trabaSanchez/Entrega-final.-Proyecto-IoT/Proyecto KiCAD(Esquematico-PCB)/simbolos descargados/CD4050BD/CD4050BD.step

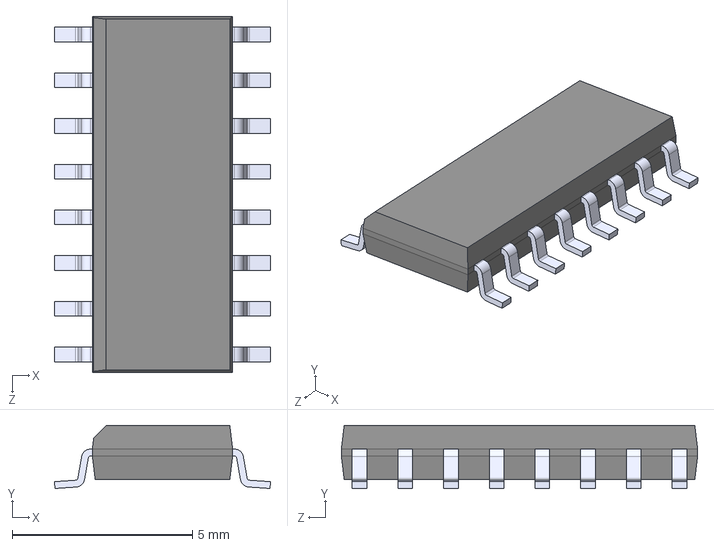
[picture p27: CAD file, 2020-12-07]
Proyecto KiCAD(Esquematico-PCB)/simbolos descargados/CD4050BD/CD4050BD.step
6.00 x 1.75 x 9.90 mm
