trabaSanchez/Entrega-final.-Proyecto-IoT/Proyecto KiCAD(Esquematico-PCB)/simbolos descargados/L80RE-M37/L80RE-M37.step

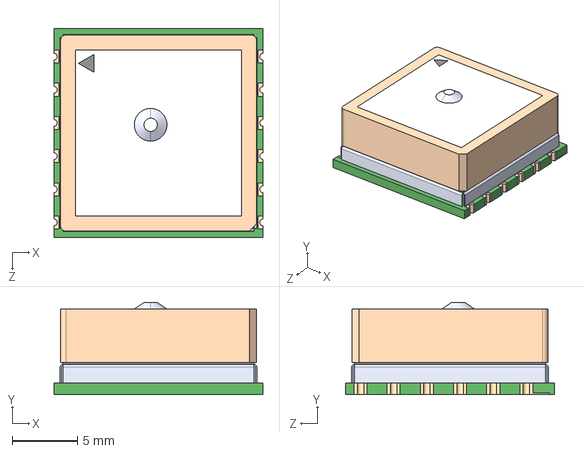
[picture p28: CAD file, 2020-12-07]
Proyecto KiCAD(Esquematico-PCB)/simbolos descargados/L80RE-M37/L80RE-M37.step
16.0 x 7.05 x 16.0 mm
