trabaSanchez/Entrega-final.-Proyecto-IoT/Proyecto KiCAD(Esquematico-PCB)/simbolos descargados/LGA12R50P4X4_200X200X86/LGA12R50P4X4_200X200X86.step

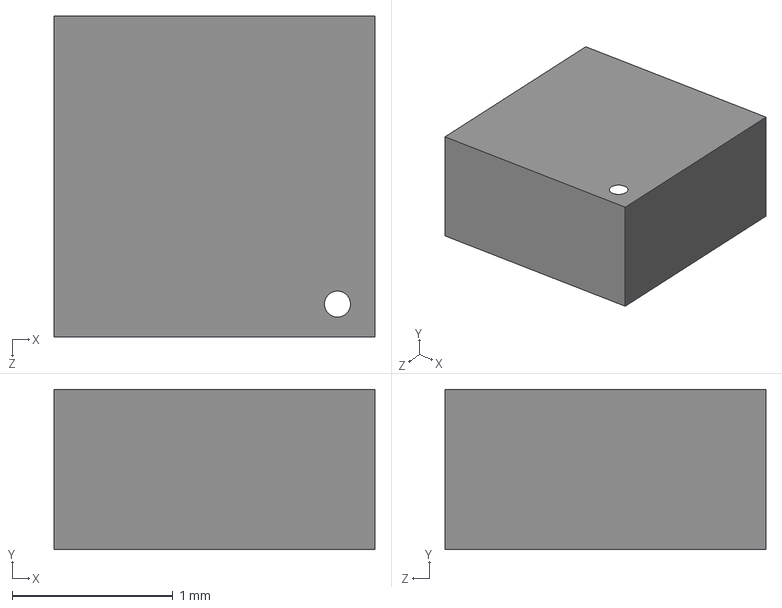
[picture p29: CAD file, 2020-12-07]
Proyecto KiCAD(Esquematico-PCB)/simbolos descargados/LGA12R50P4X4_200X200X86/LGA12R50P4X4_200X200X86.step
2.00 x 1.00 x 2.00 mm
