trabaSanchez/Entrega-final.-Proyecto-IoT/Proyecto KiCAD(Esquematico-PCB)/simbolos descargados/LIB_MCP1793T-3302H_DC/MCP1793T-3302H_DC/3D/MCP1793T-3302H_DC.stp

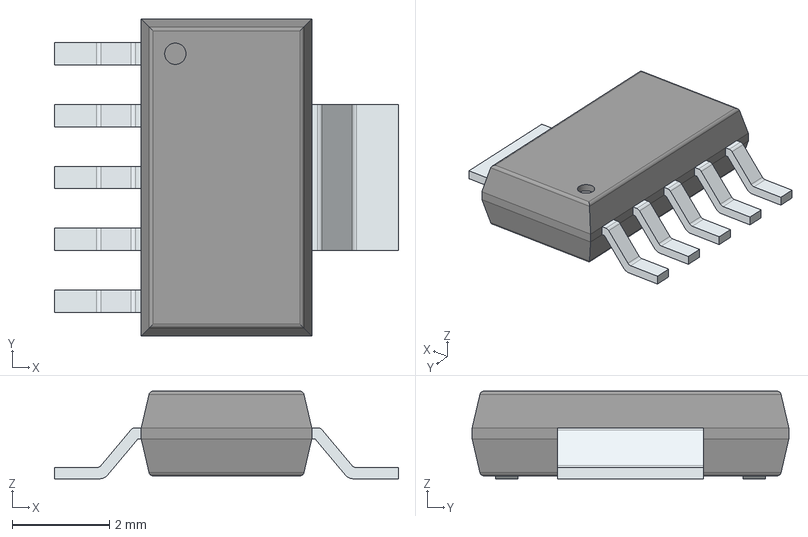
[picture p30: CAD file, 2020-12-07]
Proyecto KiCAD(Esquematico-PCB)/simbolos descargados/LIB_MCP1793T-3302H_DC/MCP1793T-3302H_DC/3D/MCP1793T-3302H_DC.stp
7.06 x 6.50 x 1.80 mm
PinsArrayL
FilletPinR
