trabaSanchez/Entrega-final.-Proyecto-IoT/Proyecto KiCAD(Esquematico-PCB)/simbolos descargados/ST-TF-003A/ST-TF-003A.step

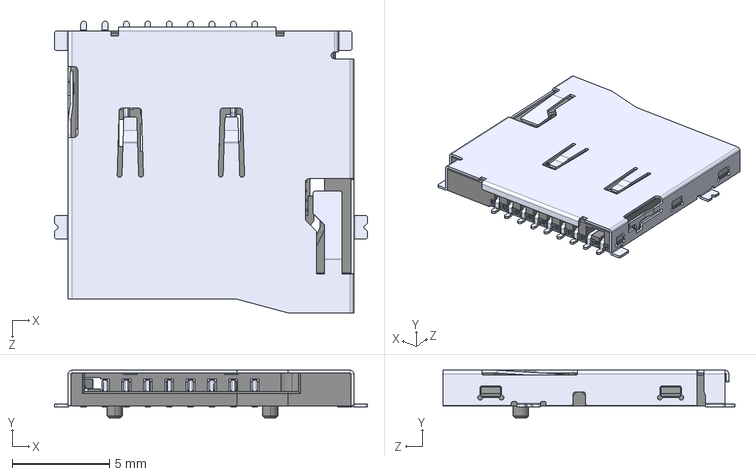
[picture p31: CAD file, 2020-12-07]
Proyecto KiCAD(Esquematico-PCB)/simbolos descargados/ST-TF-003A/ST-TF-003A.step
16.1 x 2.45 x 15.0 mm
