trabaSanchez/Entrega-final.-Proyecto-IoT/Proyecto KiCAD(Esquematico-PCB)/simbolos descargados/LIB_MP28164GD-P/MP28164GD-P/3D/MP28164GD-P.stp

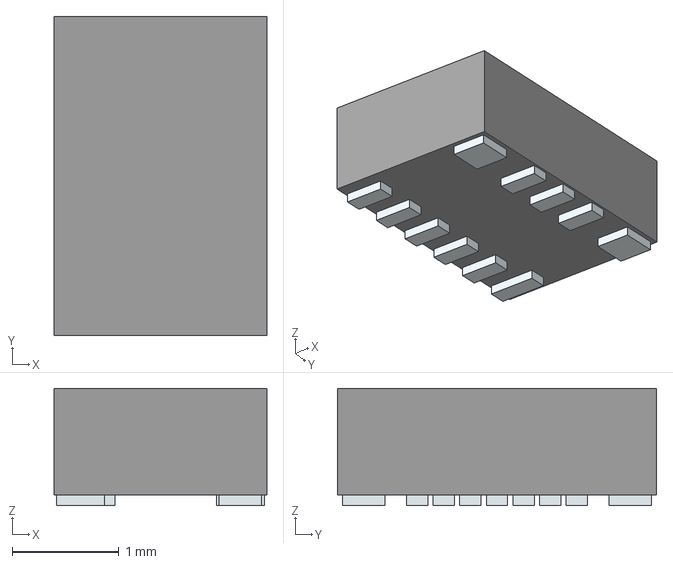
[picture p32: CAD file, 2020-12-07]
Proyecto KiCAD(Esquematico-PCB)/simbolos descargados/LIB_MP28164GD-P/MP28164GD-P/3D/MP28164GD-P.stp
2.00 x 3.00 x 1.10 mm
Pins
