trabaSanchez/Entrega-final.-Proyecto-IoT/(list of files, cad)

Other CAD files:
Proyecto KiCAD(Esquematico-PCB)/simbolos descargados/LIB_MCP1793T-3302H_DC/MCP1793T-3302H_DC/3D/MCP1793T-3302H_DC.stl
Proyecto KiCAD(Esquematico-PCB)/simbolos descargados/LIB_MCP1793T-3302H_DC/MCP1793T-3302H_DC/Allegro/sot127p706x180-6n.psm
Proyecto KiCAD(Esquematico-PCB)/simbolos descargados/LIB_MCP1793T-3302H_DC/MCP1793T-3302H_DC/DEHDL/mcp1793t_3302h_dc/chips/chips.prt
Proyecto KiCAD(Esquematico-PCB)/simbolos descargados/LIB_MP28164GD-P/MP28164GD-P/3D/MP28164GD-P.stl
Proyecto KiCAD(Esquematico-PCB)/simbolos descargados/LIB_MP28164GD-P/MP28164GD-P/Allegro/mp28164gdp.psm
Proyecto KiCAD(Esquematico-PCB)/simbolos descargados/LIB_MP28164GD-P/MP28164GD-P/DEHDL/mp28164gd_p/chips/chips.prt
