trabaSanchez/Entrega-final.-Proyecto-IoT/Documentación/HELIOT_PRESENTACION.pdf

# HELIOT

Jhonatan Rodríguez

Leonardo Sánchez
Cristian Montaño

01

# Problema

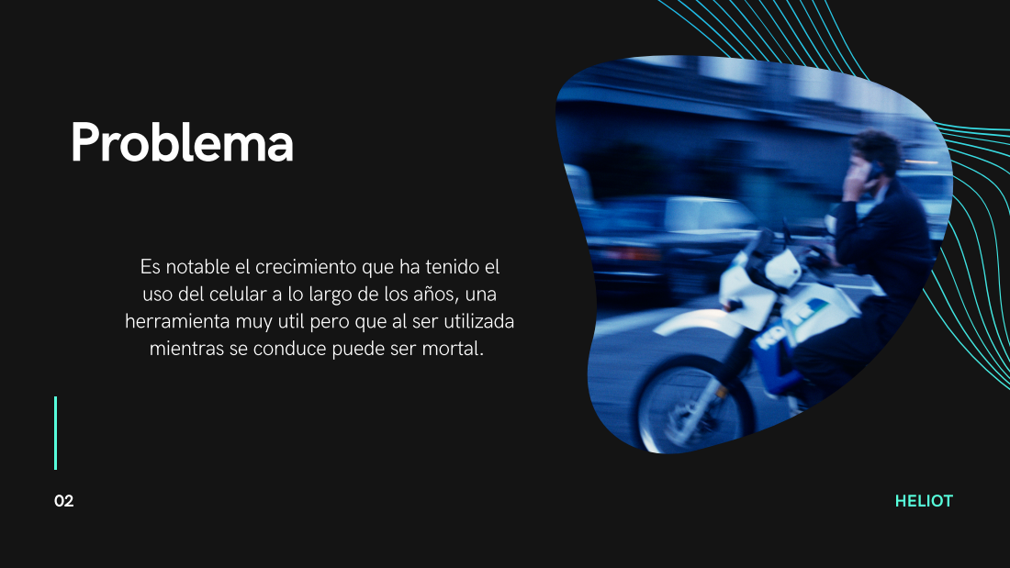
[picture p33: page 2]
HELIOT

Es notable el crecimiento que ha tenido el

uso del celular a lo largo de los años, una

herramienta muy util pero que al ser utilizada

mientras se conduce puede ser mortal.

# Problema

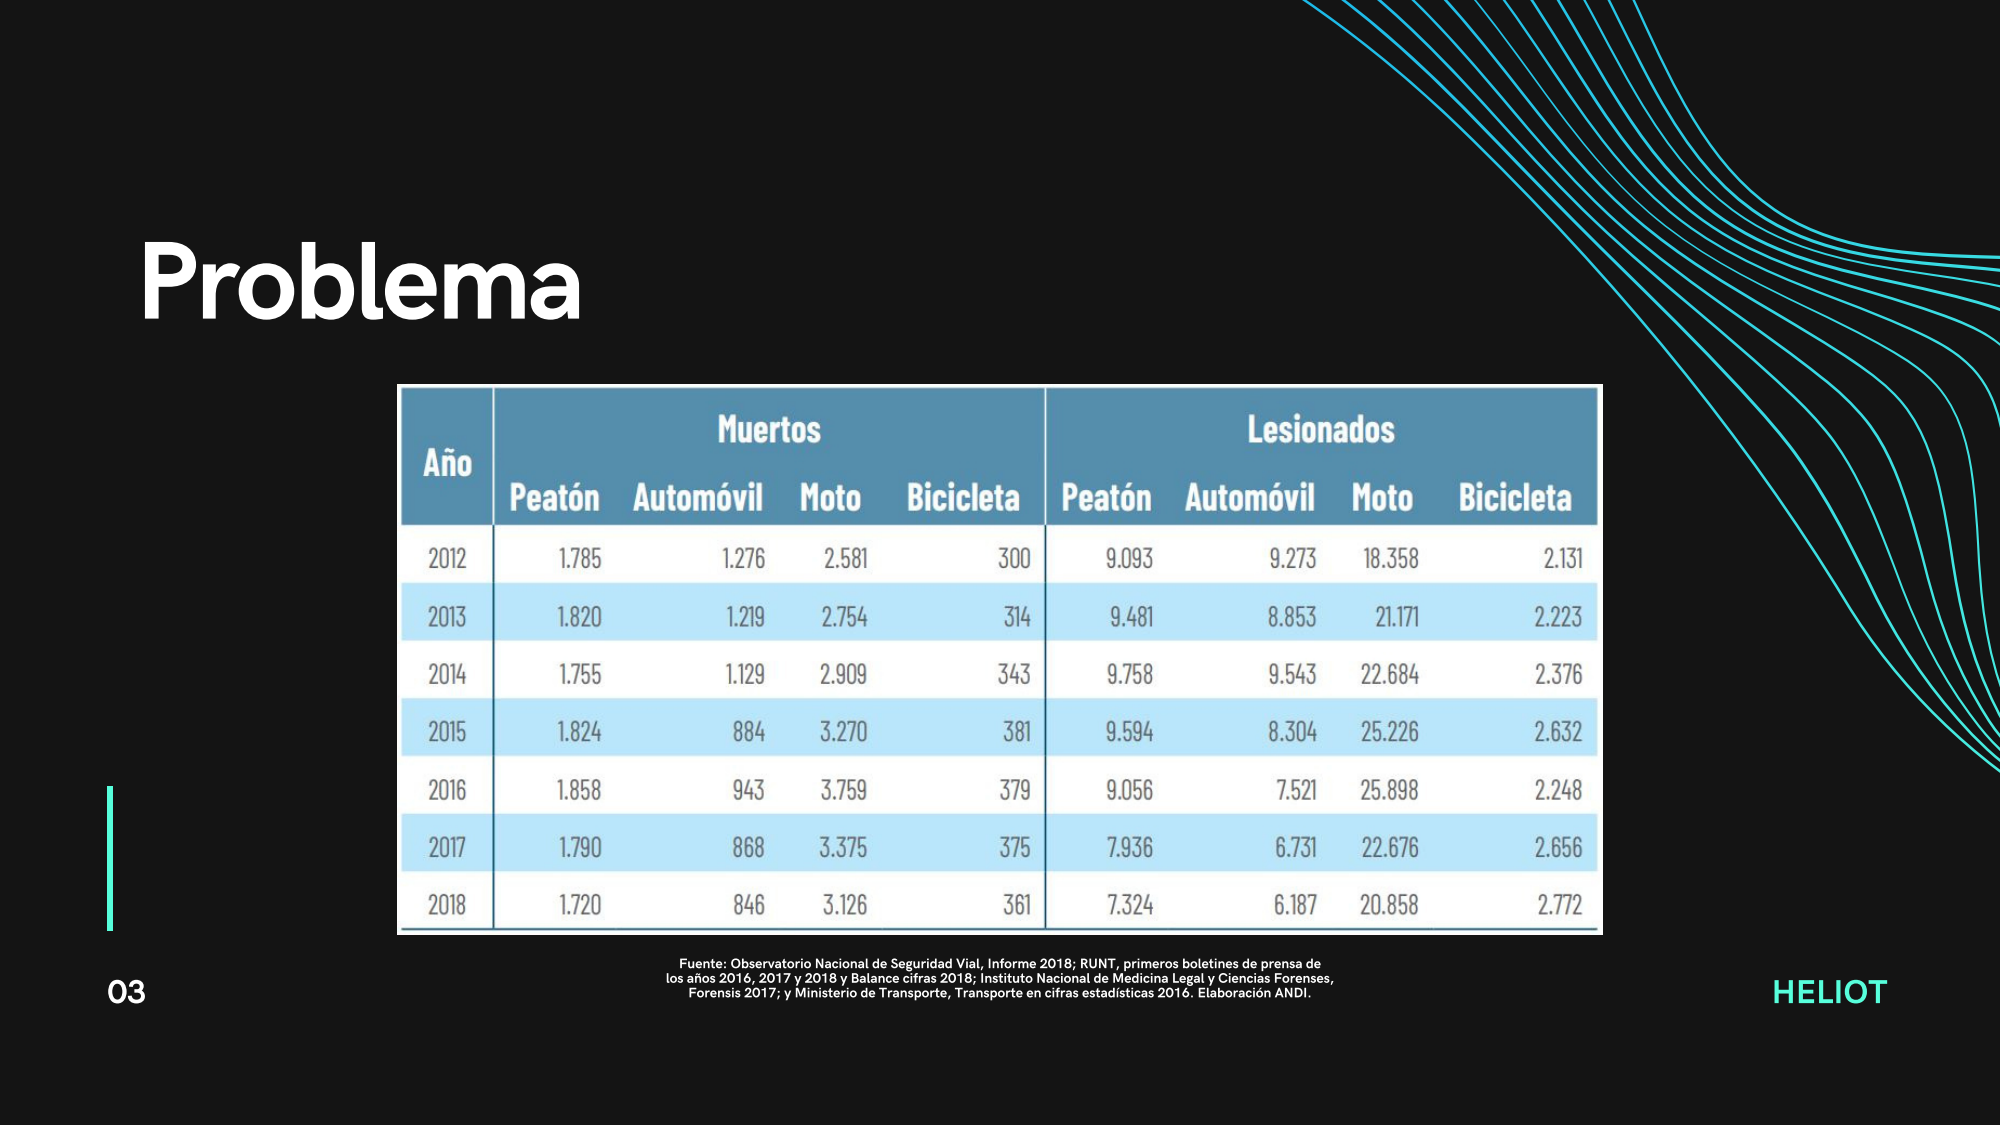
[picture p34: page 3]
HELIOT

Fuente: Observatorio Nacional de Seguridad Vial, Informe 2018; RUNT, primeros boletines de prensa de
los años 2016, 2017 y 2018 y Balance cifras 2018; Instituto Nacional de Medicina Legal y Ciencias Forenses,
Forensis 2017; y Ministerio de Transporte, Transporte en cifras estadísticas 2016. Elaboración ANDI.

HELIOT es un sistema de seguridad diseñado bajo el paradigma de IoT integrado en un casco de motocicleta el cual brinda seguridad de forma pasiva.

HELIOT monitorea constantemente los signos vitales de su portador, estos datos se envian a la red para posteriormente hacer uso de un servicio web el cual recolecta, analiza y genera alertas con base en estos.

Mediante conexión bluethooth HELIOT es capaz de conectarse con un dispositivo movil lo cual le permite

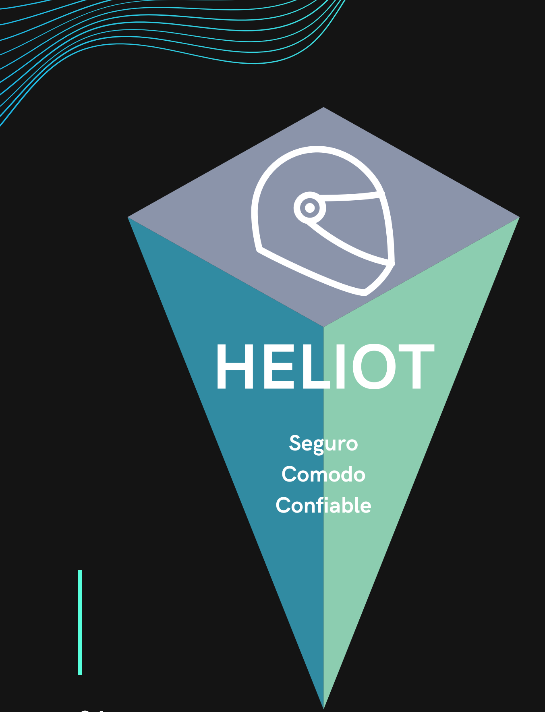
[picture p35: figure]
HELIOT; Seguro; Comodo; Confiable

hacer uso de conducción guiada y alarmas en tiempo real ⁰⁴

## MOCKUP PRELIMINAR

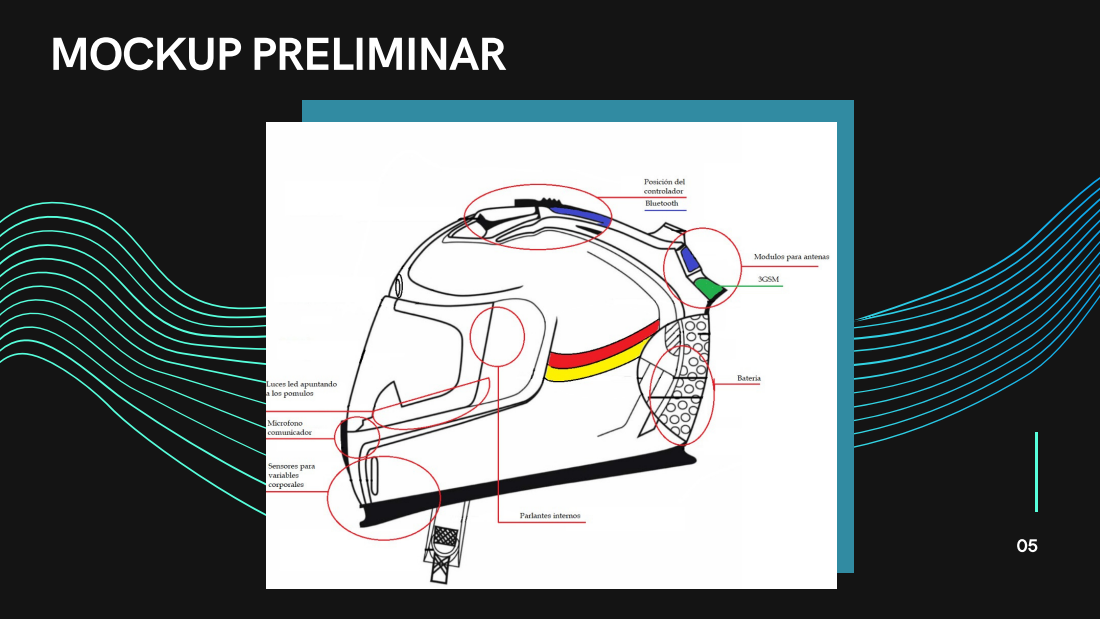
[picture p36: page 5]

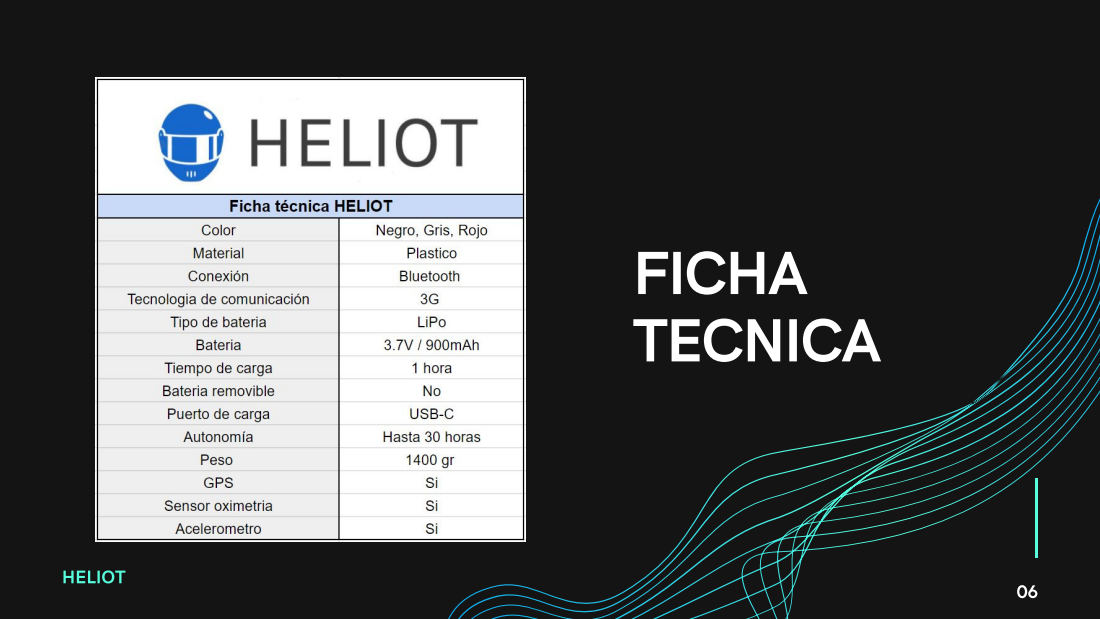
[picture p37: page 6]

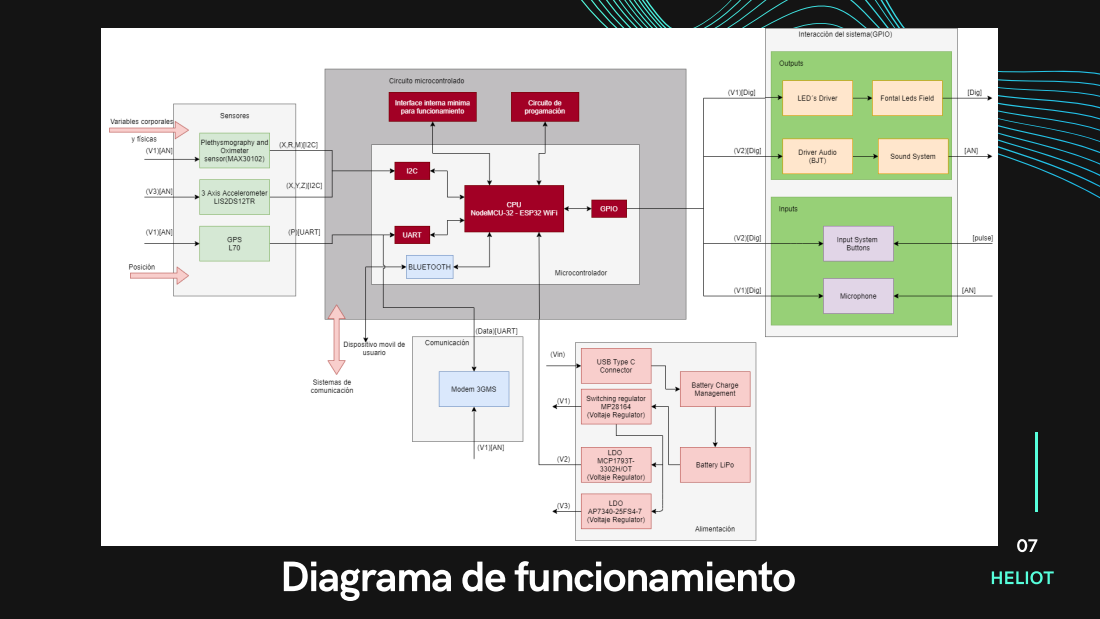
[picture p38: page 7]
Dia; cio; mie

# Esquematicos

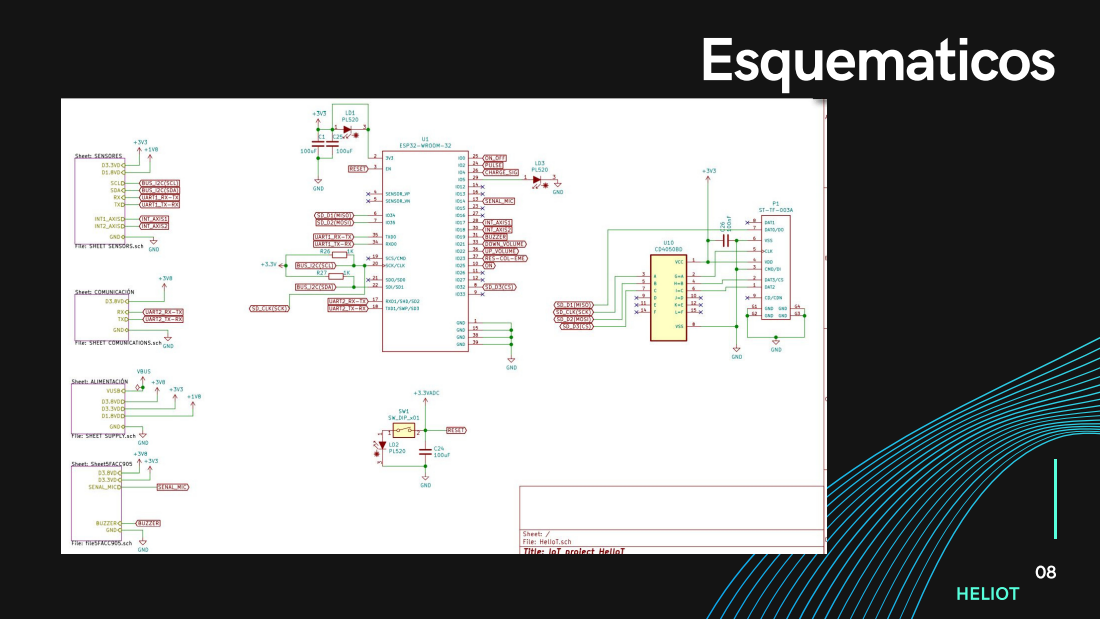
[picture p39: page 8]
HELIOT

## Alimentación

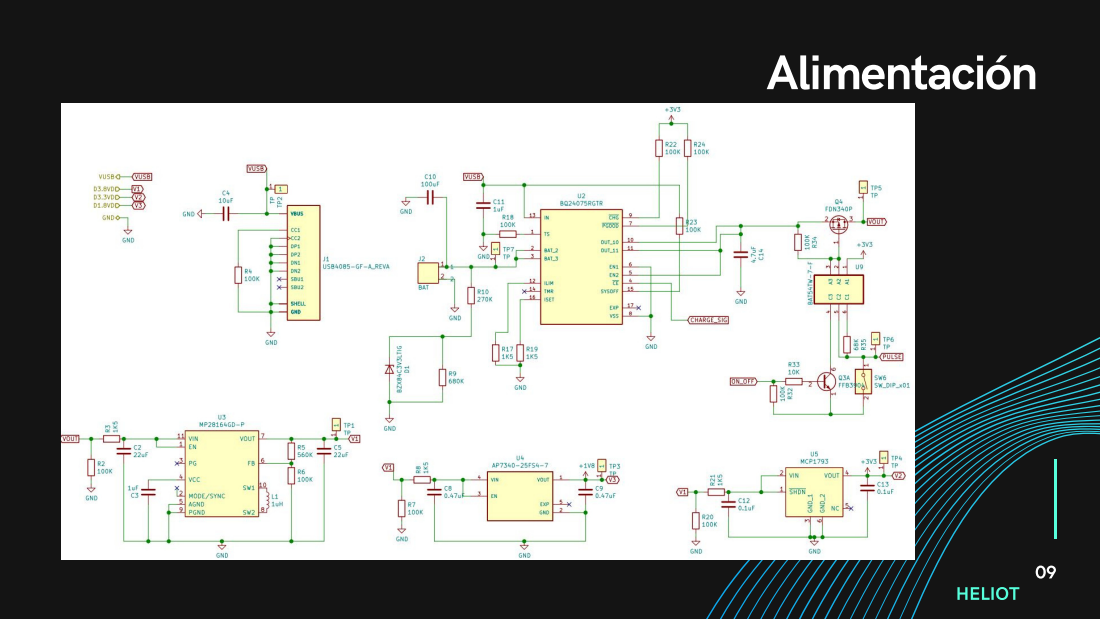
[picture p40: page 9]
HELIOT

## Comunicación / Audio

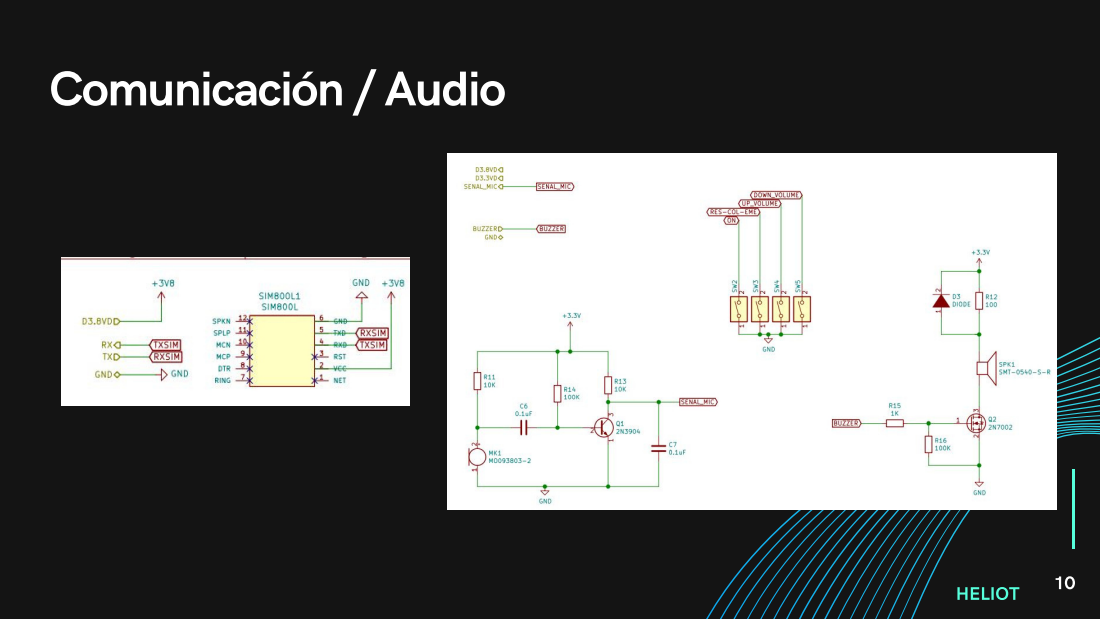
[picture p41: page 10]
HELIOT

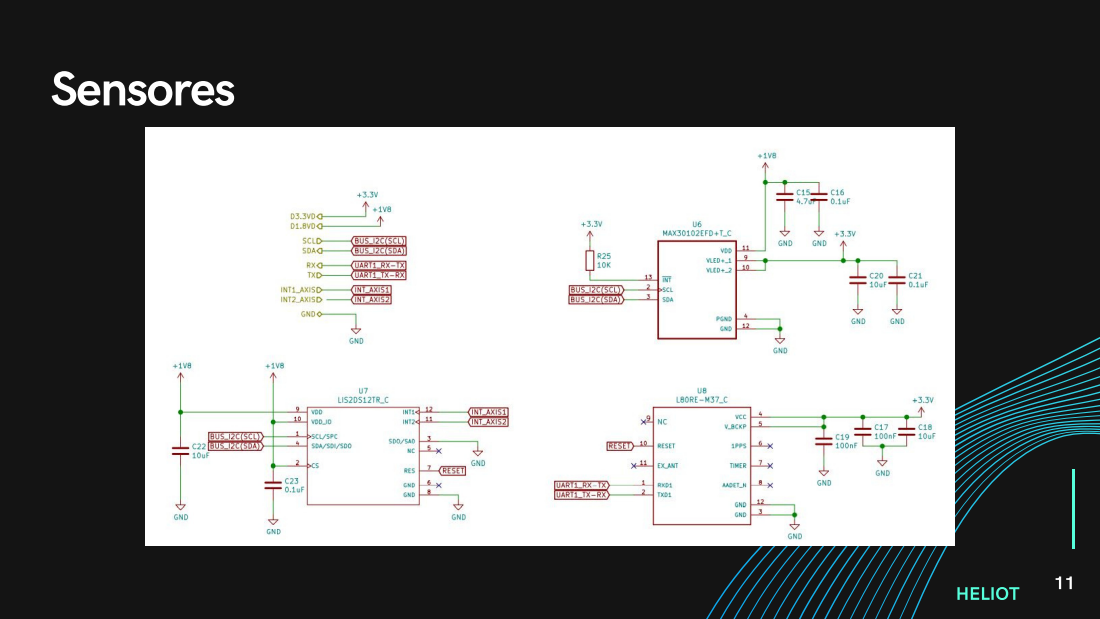
[picture p42: page 11]
Sensores; HELIOT

## PCB

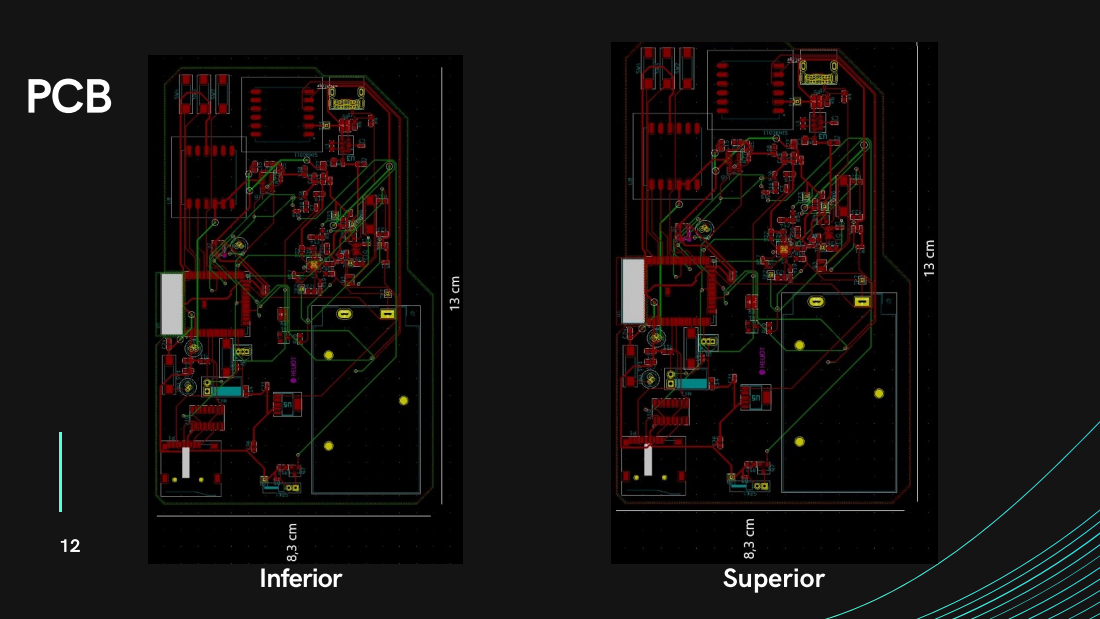
[picture p43: page 12]
Inferior; Superior

## PCB - 3D

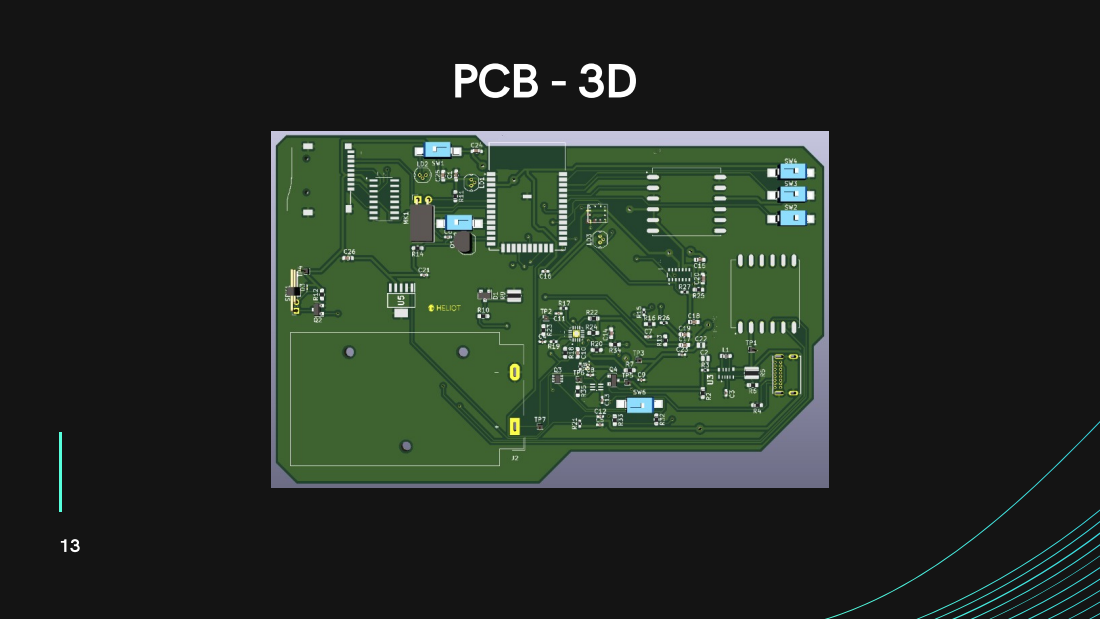
[picture p44: page 13]

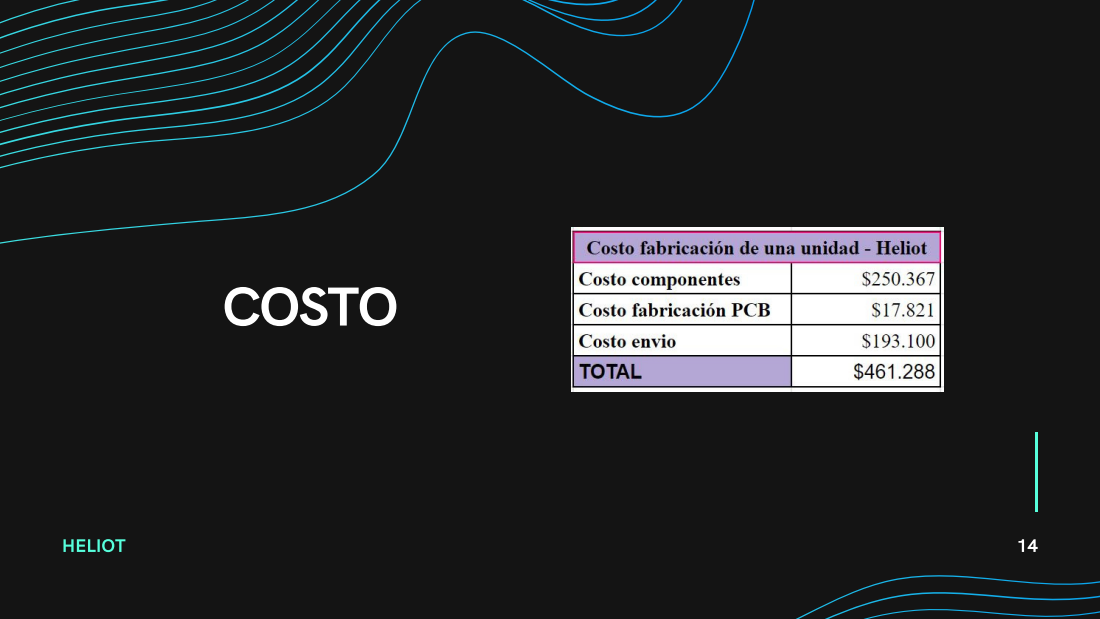
[picture p45: page 14]
HELIOT; COSTO

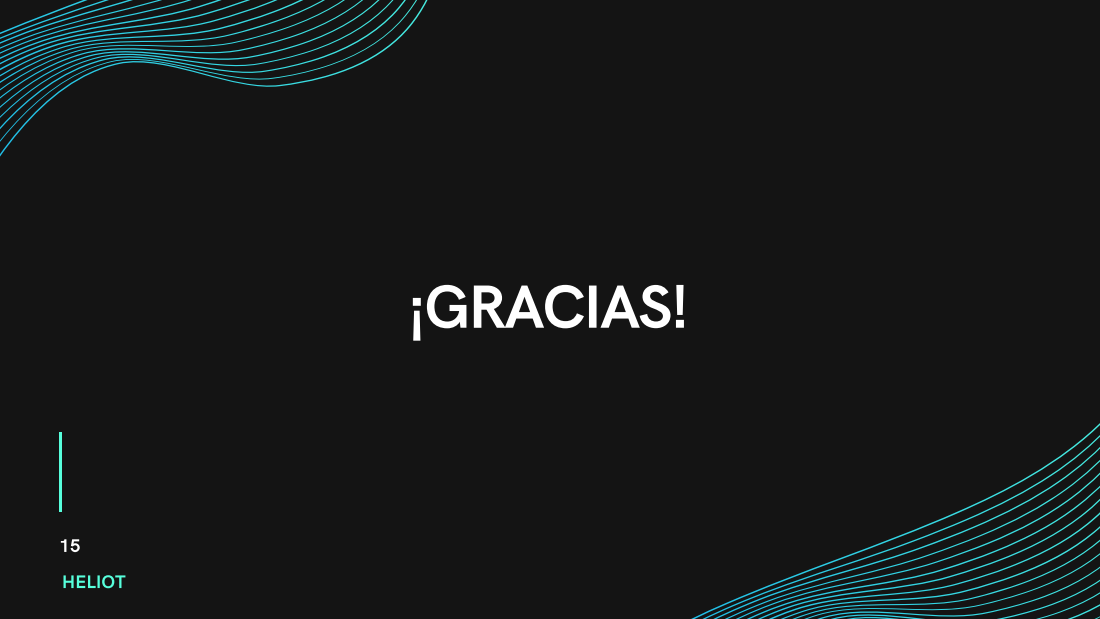
[picture p46: page 15]
¡GRACIAS!; HELIOT
