trabaSanchez/Entrega-final.-Proyecto-IoT/(list of files, drawings)

Other design files:
Proyecto KiCAD(Esquematico-PCB)/simbolos descargados/MP28164_2020-12-02_17-46-48.pcbdoc
