trabaSanchez/Entrega-final.-Proyecto-IoT/Proyecto KiCAD(Esquematico-PCB)/HelIoT.kicad_pcb

## KiCad design Proyecto KiCAD(Esquematico-PCB)/HelIoT.kicad_pcb (2020-12-07)

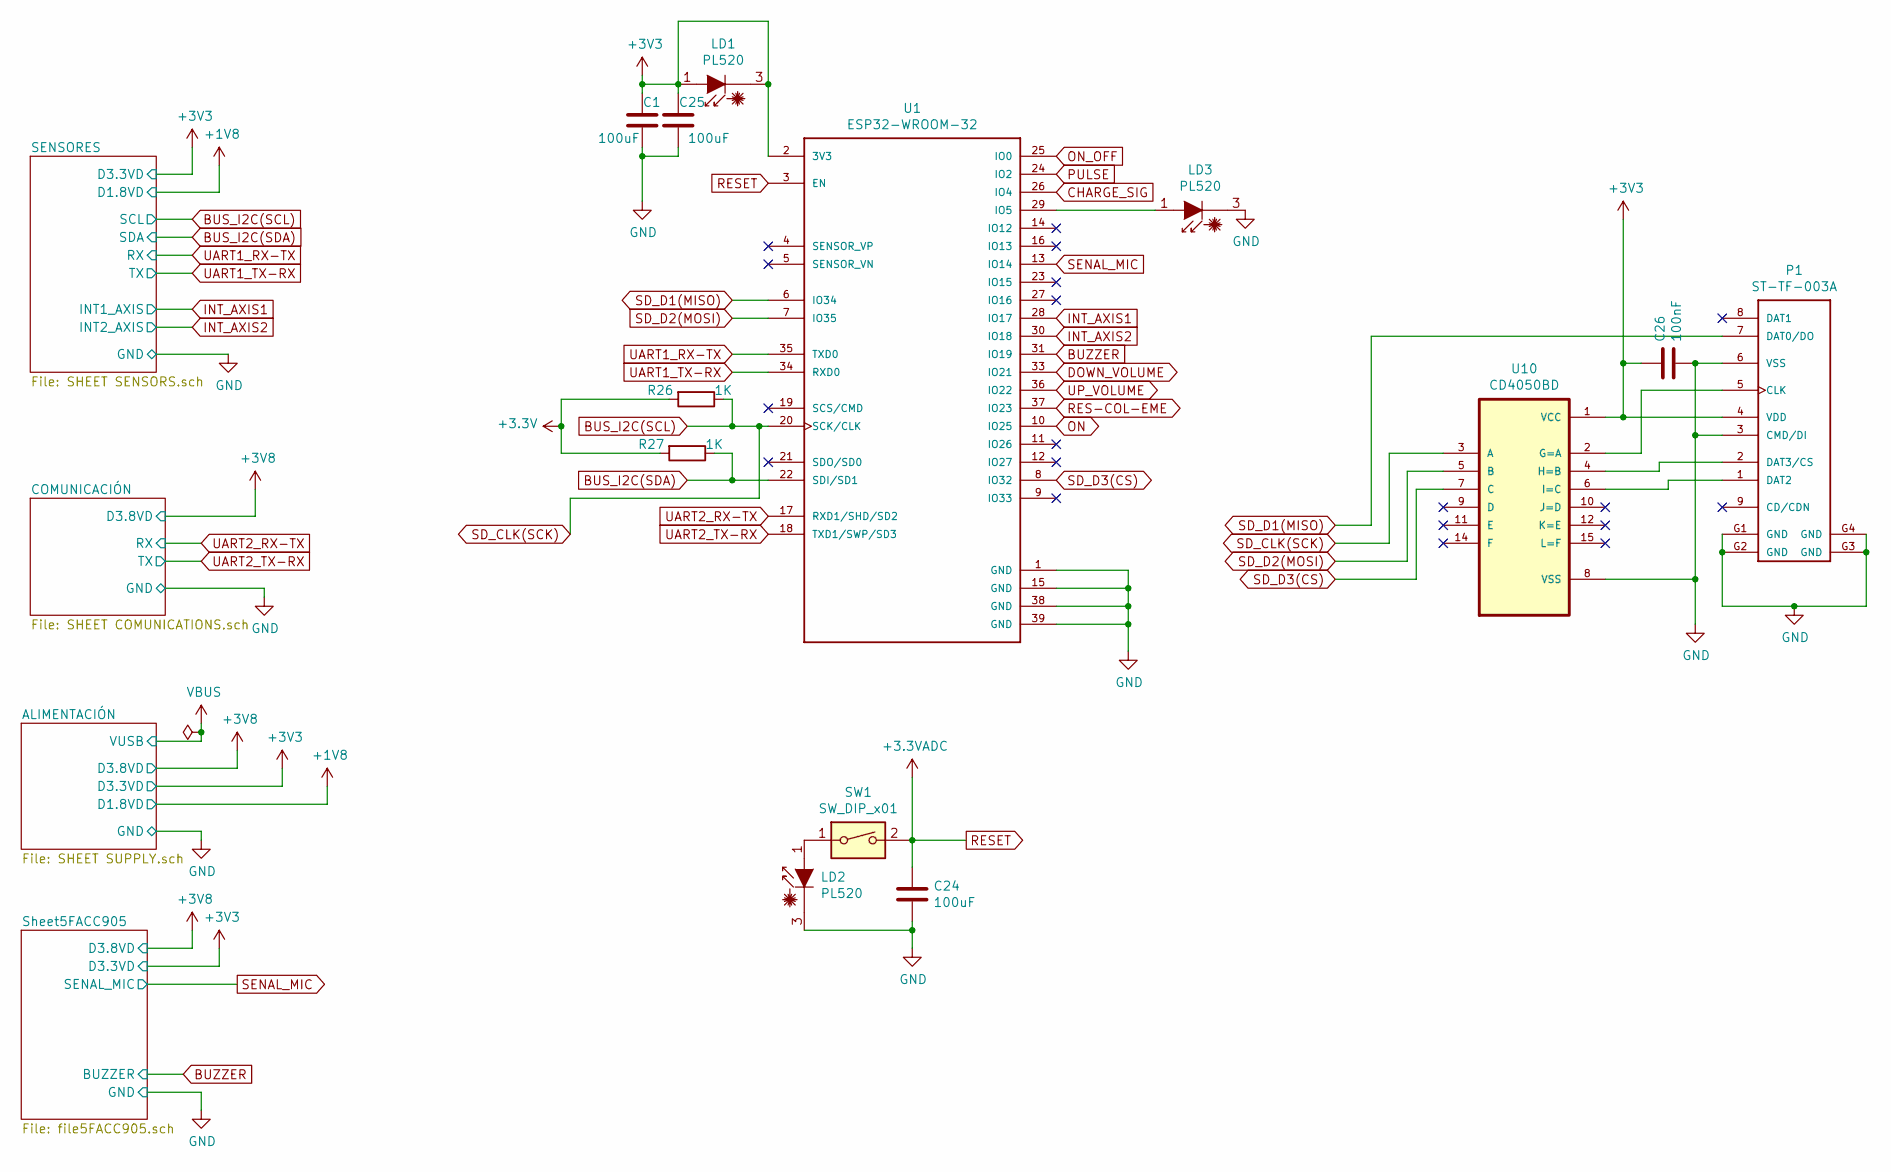
[picture p47: schematic HelIoT.sch, IoT project HelIoT]

Parts:
C1, C24, C25: 100uF; C_0603_1608Metric_Pad1.08x0.95mm_HandSolder
C26: 100nF; C_0603_1608Metric_Pad1.08x0.95mm_HandSolder
LD1, LD2, LD3: PL520; LaserDiode_TO38ICut-3
P1: ST-TF-003A; SUNTECH_ST-TF-003A
R26, R27: 1K; R_0402_1005Metric_Pad0.72x0.64mm_HandSolder
SW1: SW_DIP_x01; SW_SPST_REED_CT05-XXXX-G1
U1: ESP32-WROOM-32; MODULE_ESP32-WROOM-32
U10: CD4050BD; SOIC127P600X175-16N

Connections:
BUS_I2C(SCL): R26.1, U1.20 (SCK/CLK), U10.3 (A); also elsewhere on the board
BUS_I2C(SDA): R27.1, U1.22 (SDI/SD1); also elsewhere on the board
BUZZER: U1.31 (IO19); also elsewhere on the board
CHARGE_SIG: U1.26 (IO4); also elsewhere on the board
GND: C1.2, C24.2, C25.2, C26.2, LD2.3 (C), LD3.3 (C), P1.3 (CMD/DI), P1.6 (VSS), P1.G1 (GND), P1.G2 (GND), P1.G3 (GND), P1.G4 (GND), U1.1 (GND), U1.15 (GND), U1.38 (GND), U1.39 (GND), U10.8 (VSS); also elsewhere on the board
INT_AXIS1: U1.28 (IO17); also elsewhere on the board
INT_AXIS2: U1.30 (IO18); also elsewhere on the board
unnamed: LD2.1 (A), SW1.1
unnamed: LD3.1 (A), U1.29 (IO5)
unnamed: P1.1 (DAT2), U10.6 (I=C)
unnamed: P1.2 (DAT3/CS), U10.4 (H=B)
unnamed: P1.5 (CLK), U10.2 (G=A)
ON_OFF: U1.25 (IO0); also elsewhere on the board
PULSE: U1.24 (IO2); also elsewhere on the board
RESET: C24.1, SW1.2, U1.3 (EN); also elsewhere on the board
RXSIM: U1.18 (TXD1/SWP/SD3); also elsewhere on the board
SD_D1(MISO): P1.7 (DAT0/DO), U1.6 (IO34)
SD_D2(MOSI): U1.7 (IO35), U10.5 (B)
SD_D3(CS): U1.8 (IO32), U10.7 (C)
SENAL_MIC: U1.13 (IO14); also elsewhere on the board
TXSIM: U1.17 (RXD1/SHD/SD2); also elsewhere on the board
UART1_RX-TX: U1.35 (TXD0); also elsewhere on the board
UART1_TX-RX: U1.34 (RXD0); also elsewhere on the board
V2: C1.1, C25.1, C26.1, LD1.1 (A), LD1.3 (C), P1.4 (VDD), R26.2, R27.2, U1.2 (3V3), U10.1 (VCC); also elsewhere on the board

Schematic: SHEET SUPPLY.sch

Parts:
C2: 22uF; C_0504_1310Metric_Pad0.83x1.28mm_HandSolder
C3, C11: 1uF; C_0402_1005Metric_Pad0.74x0.62mm_HandSolder
C4: 10uF; C_0402_1005Metric_Pad0.74x0.62mm_HandSolder
C5: 22uF; C_0402_1005Metric_Pad0.74x0.62mm_HandSolder
C8, C9: 0.47uF; C_0402_1005Metric_Pad0.74x0.62mm_HandSolder
C10: 100uF; C_0603_1608Metric_Pad1.08x0.95mm_HandSolder
C12, C13: 0.1uF; C_0402_1005Metric_Pad0.74x0.62mm_HandSolder
C14: 4.7uF; C_0603_1608Metric_Pad1.08x0.95mm_HandSolder
D1: BZX84C3V3LTIG; D_SOT-23_ANK
J1: USB4085-GF-A_REVA; GCT_USB4085-GF-A_REVA
J2: BAT; BatteryHolder_MPD_BA9VPC_1xPP3
L1: 1uH; L_0603_1608Metric_Pad1.05x0.95mm_HandSolder
Q3: FFB3904; SOT-363_SC-70-6
Q4: FDN340P; SOT-23
R2, R4, R6, R7, R18, R20, R22, R23, R24, R32, R34: 100K; R_0603_1608Metric_Pad0.98x0.95mm_HandSolder
R3, R8, R17, R19, R21: 1K5; R_0402_1005Metric_Pad0.72x0.64mm_HandSolder
R5: 560K; R_0612_1632Metric_Pad1.18x3.40mm_HandSolder
R9: 680K; R_0612_1632Metric_Pad1.18x3.40mm_HandSolder
R10: 270K; R_0603_1608Metric_Pad0.98x0.95mm_HandSolder
R33: 10K; R_0603_1608Metric_Pad0.98x0.95mm_HandSolder
R35: 68K; R_0603_1608Metric_Pad0.98x0.95mm_HandSolder
SW6: SW_DIP_x01; SW_SPST_REED_CT05-XXXX-G1
TP1, TP2, TP3, TP4, TP5, TP6, TP7: TP; PinHeader_1x01_P1.00mm_Vertical
U2: BQ24075RGTR; QFN50P300X300X100-17N
U3: MP28164GD-P; MP28164GDP
U4: AP7340-25FS4-7; VREG_AP7340-25FS4-7; PARTREV 5 - 2
U5: MCP1793; SOT127P706X180-6N
U9: BAT54TW-7-F; SOT65P220X110-6N; MPN BAT54TW-7-F

Connections:
CHARGE_SIG: U2.4 (~CE); also elsewhere on the board
GND: C2.2, C3.1, C4.2, C5.2, C8.2, C9.2, C10.2, C11.2, C12.2, C13.2, C14.1, D1.2 (A), J1.A1 (GND), J1.A6 (DP1), J1.A7 (DN1), J1.A12 (GND), J1.B1 (GND), J1.B5 (CC2), J1.B6 (DP2), J1.B7 (DN2), J1.B12 (GND), J1.P1 (SHELL), J1.P2 (SHELL), J1.P3 (SHELL), J1.P4 (SHELL), J2.2, R2.2, R4.2, R6.2, R7.2, R9.2, R17.2, R18.2, R19.2, R20.2, U2.6 (EN1), U2.8 (VSS), U3.5, U3.9, U4.2 (GND), U5.3, U5.6; also elsewhere on the board
unnamed: C2.1, R3.2, U3.1, U3.11
unnamed: C3.2, U3.4
unnamed: C8.1, R8.2, U4.3 (EN), U4.4 (VIN)
unnamed: C10.1, J2.1, R10.1, TP7.1, U2.2 (BAT_2), U2.3 (BAT_3)
unnamed: C12.1, R21.2, U5.1, U5.2
unnamed: C14.2, Q4.2 (S), R34.2, U2.5 (EN2), U2.10 (OUT_10), U2.11 (OUT_11)
unnamed: D1.1 (K), R9.1, R10.2
unnamed: J1.A5 (CC1), R4.1
unnamed: L1.1, U3.10
unnamed: L1.2, U3.8
unnamed: Q3.1 (E1), R32.1, SW6.2
unnamed: Q3.2 (B1), R33.1
unnamed: Q3.6 (C1), U9.4 (C3)
unnamed: Q4.1 (G), R34.1, U9.2 (A2), U9.3 (A3)
unnamed: R5.2, R6.1, U3.6
unnamed: R17.1, U2.12 (ILIM)
unnamed: R18.1, U2.1 (TS)
unnamed: R19.1, U2.16 (ISET)
unnamed: R22.2, U2.9 (~CHG)
unnamed: R23.2, U2.15 (SYSOFF)
unnamed: R24.2, U2.7 (~PGOOD)
unnamed: R35.2, U9.6 (C1)
ON_OFF: R32.2, R33.2; also elsewhere on the board
PULSE: R35.1, SW6.1, TP6.1, U9.5 (C2); also elsewhere on the board
V1: C5.1, R5.1, R7.1, R8.1, R20.1, R21.1, TP1.1, U3.7; also elsewhere on the board
V2: C13.1, R22.1, R24.1, TP4.1, U5.4, U9.1 (A1); also elsewhere on the board
V3: C9.1, TP3.1, U4.1 (VOUT); also elsewhere on the board
VOUT: Q4.3 (D), R2.1, R3.1, TP5.1
VUSB: C4.1, C11.1, J1.A4 (VBUS), J1.A9 (VBUS), J1.B4 (VBUS), J1.B9 (VBUS), R23.1, TP2.1, U2.13 (IN)

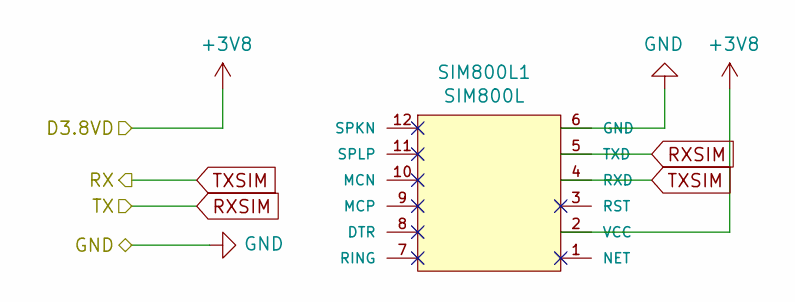
[picture p48: schematic SHEET COMUNICATIONS.sch]

Parts:
SIM800L1: SIM800L; SIM800L1

Connections:
GND: SIM800L1.6 (GND); also elsewhere on the board
RXSIM: SIM800L1.5 (TXD); also elsewhere on the board
TXSIM: SIM800L1.4 (RXD); also elsewhere on the board
V1: SIM800L1.2 (VCC); also elsewhere on the board

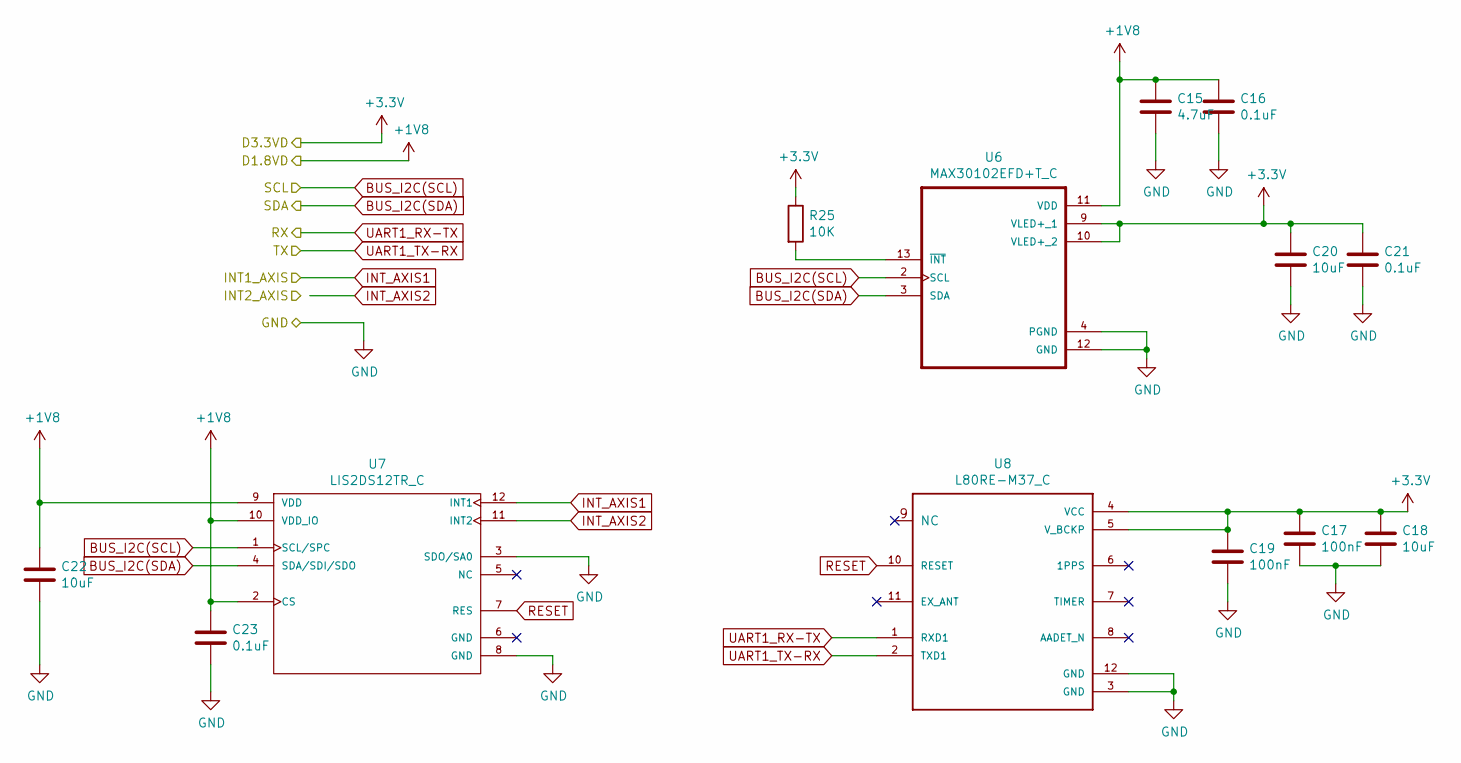
[picture p49: schematic SHEET SENSORS.sch]

Parts:
C15: 4.7uF; C_0603_1608Metric_Pad1.08x0.95mm_HandSolder
C16, C21, C23: 0.1uF; C_0402_1005Metric_Pad0.74x0.62mm_HandSolder
C17, C19: 100nF; C_0603_1608Metric_Pad1.08x0.95mm_HandSolder
C18, C20: 10uF; C_0603_1608Metric_Pad1.08x0.95mm_HandSolder
C22: 10uF; C_0504_1310Metric_Pad0.83x1.28mm_HandSolder
R25: 10K; R_0603_1608Metric_Pad0.98x0.95mm_HandSolder
U6: MAX30102EFD+T_C; XDCR_MAX30101EFD+
U7: LIS2DS12TR_C; LGA12R50P4X4_200X200X86
U8: L80RE-M37_C; XCVR_L80RE-M37

Connections:
BUS_I2C(SCL): U6.2 (SCL), U7.1 (SCL/SPC); also elsewhere on the board
BUS_I2C(SDA): U6.3 (SDA), U7.4 (SDA/SDI/SDO); also elsewhere on the board
GND: C15.2, C16.2, C17.2, C18.2, C19.2, C20.2, C21.2, C22.2, C23.2, U6.4 (PGND), U6.12 (GND), U7.3 (SDO/SA0), U7.8 (GND), U8.3 (GND), U8.12 (GND); also elsewhere on the board
INT_AXIS1: U7.12 (INT1); also elsewhere on the board
INT_AXIS2: U7.11 (INT2); also elsewhere on the board
unnamed: R25.2, U6.13 (~INT~)
RESET: U7.7 (RES), U8.10 (RESET); also elsewhere on the board
UART1_RX-TX: U8.1 (RXD1); also elsewhere on the board
UART1_TX-RX: U8.2 (TXD1); also elsewhere on the board
V2: C17.1, C18.1, C19.1, C20.1, C21.1, R25.1, U6.9 (VLED+_1), U6.10 (VLED+_2), U8.4 (VCC), U8.5 (V_BCKP); also elsewhere on the board
V3: C15.1, C16.1, C22.1, C23.1, U6.11 (VDD), U7.2 (CS), U7.9 (VDD), U7.10 (VDD_IO); also elsewhere on the board

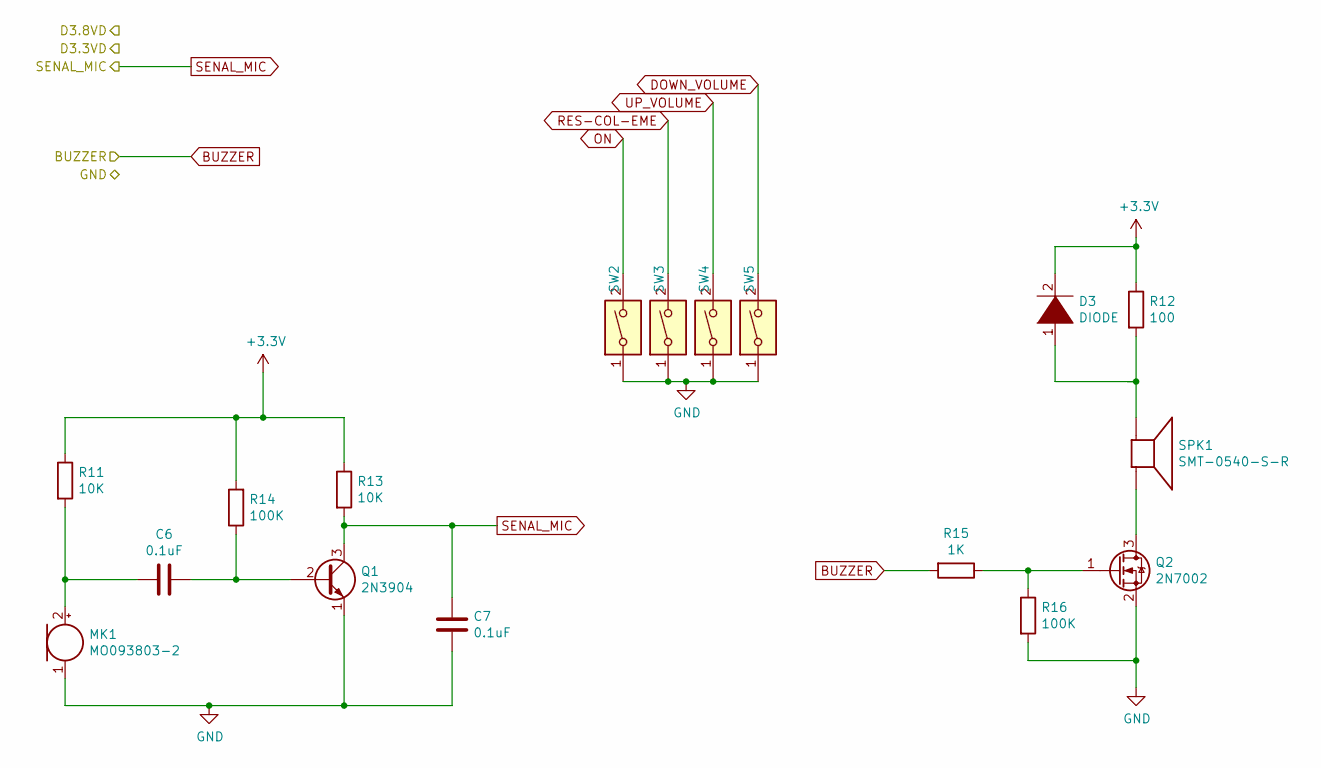
[picture p50: schematic file5FACC905.sch]

Parts:
C6, C7: 0.1uF; C_0402_1005Metric_Pad0.74x0.62mm_HandSolder
D3: DIODE; D_0201_0603Metric_Pad0.64x0.40mm_HandSolder
MK1: MO093803-2; PinSocket_1x02_P2.54mm_Horizontal
Q1: 2N3904; TO-92_Inline
Q2: 2N7002; SOT-23
R11, R13: 10K; R_0603_1608Metric_Pad0.98x0.95mm_HandSolder
R12: 100; R_0603_1608Metric_Pad0.98x0.95mm_HandSolder
R14, R16: 100K; R_0603_1608Metric_Pad0.98x0.95mm_HandSolder
R15: 1K; R_0402_1005Metric_Pad0.72x0.64mm_HandSolder
SPK1: SMT-0540-S-R; PinHeader_2x01_P2.00mm_Horizontal
SW2, SW3, SW4, SW5: SW_DIP_x01; SW_SPST_REED_CT05-XXXX-G1

Connections:
BUZZER: R15.2; also elsewhere on the board
GND: C7.2, MK1.1 (-), Q1.1 (E), Q2.2 (S), R16.2, SW2.1, SW3.1, SW4.1, SW5.1; also elsewhere on the board
unnamed: C6.1, Q1.2 (B), R14.1
unnamed: C6.2, MK1.2 (+), R11.2
unnamed: D3.1 (K), R12.2, SPK1.-
unnamed: Q2.1 (G), R15.1, R16.1
unnamed: Q2.3 (D), SPK1.+
SENAL_MIC: C7.1, Q1.3 (C), R13.2; also elsewhere on the board
V2: D3.2 (A), R11.1, R12.1, R13.1, R14.2; also elsewhere on the board

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
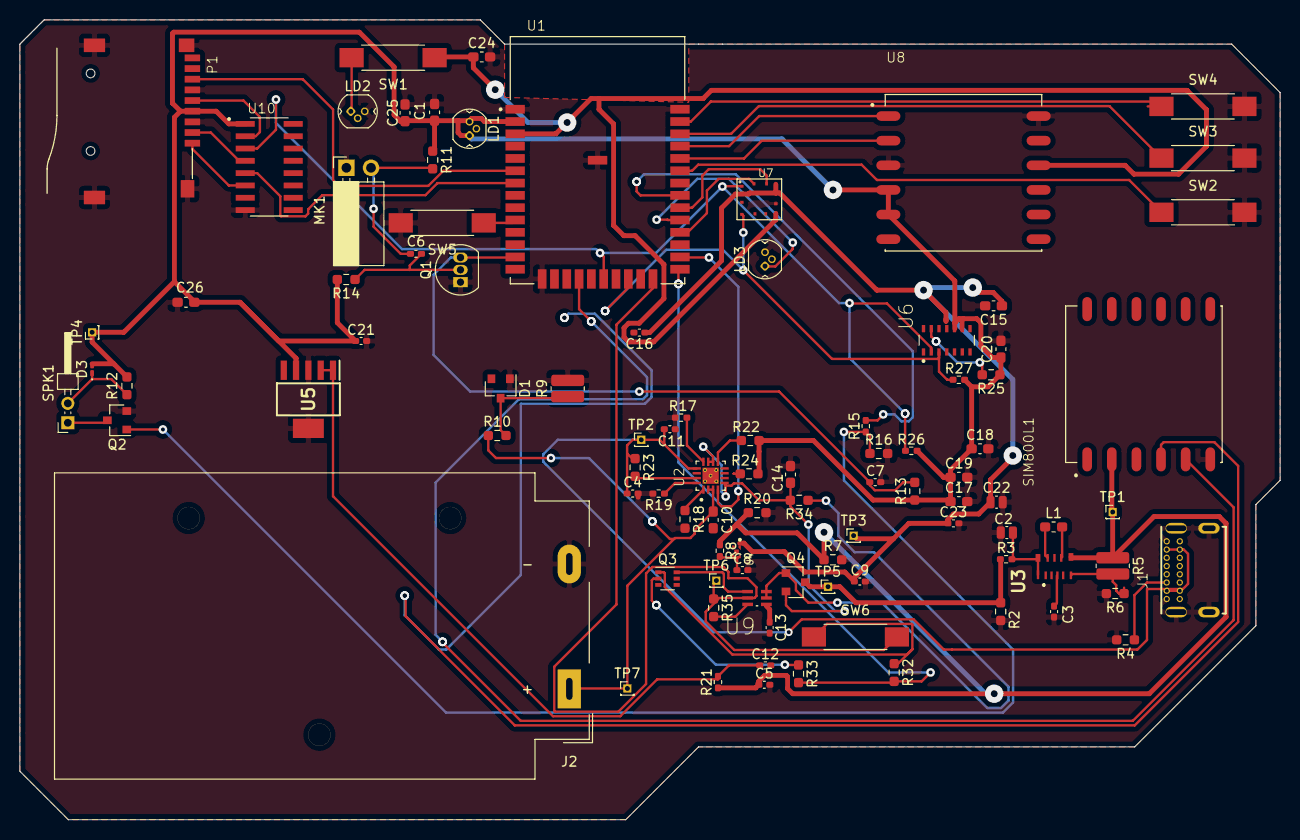
[picture p51: board HelIoT.kicad_pcb from above]

Board: 2 copper layers, 130.0 x 82.5 mm, 95 parts (0 on the bottom side), 60 nets.
